ZwinnySerwis/axidraw-modern/tools/ebb_sim/README.md

# Emulator protokołu EBB

Model firmware bez płytki. Testy:

```powershell
python -m pytest
```

Interakcja z terminala (jedna komenda na linię):

```powershell
python -m tools.ebb_sim.repl
```
