ZwinnySerwis/axidraw-modern/hardware/PROTO-SCIEGA.html

# axidraw-modern — ściąga prototypu (Pico RP2040)

UF2: firmware/build/axidraw_modern.uf2 · BOOTSEL → dysk RPI-RP2 · LED miga = żyje · USB ma się nazywać EiBotBoard

## Pico — USB u góry, numery nóżek płytki

 lewa (1–20)              prawa (40–21)
 GP0  1  ●          ● 40 VBUS     USB
 GP1  2  ●          ● 39 VSYS
 GND  3  ●          ● 38 GND
 GP2  4  ● STEP1    ● 37 3V3_EN
 GP3  5  ● DIR1     ● 36 3V3(OUT)  → logika sticków
 GP4  6  ● EN1      ● 35 ADC_VREF
 GP5  7  ● STEP2    ● 34 GP28 ADC VMOT
 GND  8  ●          ● 33 GND
 GP6  9  ● DIR2     ● 32 GP27 I2C1 SCL  [później]
 GP7 10  ● EN2      ● 31 GP26 I2C1 SDA  [później]
 GP8 11  ● TMC TX   ● 30 RUN
 GP9 12  ● TMC RX   ● 29 GP22 IMU INT1  [później]
 GND 13  ●          ● 28 GND
GP10 14  ● MS1      ● 27 GP21 spare
GP11 15  ● MS2      ● 26 GP20 spare
GP12 16  ● MS3      ● 25 GP19 SPI MOSI  [później]
GP13 17  ● EN3      ● 24 GP18 SPI SCK   [później]
 GND 18  ●          ● 23 GND
GP14 19  ● PAUSE    ● 22 GP17 SPI CS    [później]
GP15 20  ● SERVO    ● 21 GP16 SPI MISO  [później]

GP = numer w firmware. Nóżka = dziurka na Pico. LED = GP25 onboard, nie łączyć.

## Teraz na stole (żółte)

Sygnał | GP | Nóżka | Dokąd
STEP1 | 2 | 4 | stick 1 STEP
DIR1 | 3 | 5 | stick 1 DIR
EN1 (LOW=on) | 4 | 6 | stick 1 EN
STEP2 (+ stick 3) | 5 | 7 | stick 2 i 3 STEP
DIR2 (+ stick 3) | 6 | 9 | stick 2 i 3 DIR
EN2 (LOW=on) | 7 | 10 | stick 2 EN
MS1 / MS2 / MS3 | 10/11/12 | 14/15/16 | luz = pełny krok; firmware MOTION_STEP_DIV=16. 1/16: MS→3V3 i DIV=1
EN3 (LOW=on) | 13 | 17 | stick 3 EN
PAUSE | 14 | 19 | przycisk → GND (pull-up w Pico)
SERVO PWM | 15 | 20 | sygnał serwa (nie 5 V z Pico)
ADC VMOT | 28 | 34 | dzielnik 12 V → 3V3 max
3V3 | — | 36 | VDD sticków, SLEEP, RESET
GND | — | 3/8/13/18/23/28/33/38 | wspólna masa ze zasilaczem silników

## Stepstick 16-pin (A4988 / DRV8825 / TMC) — EN u góry z lewej

 EN     ● ●  VMOT     ← 12–24 V z zasilacza, NIE z Pico
 MS1    ● ●  GND      ← masa wspólna
 MS2    ● ●  2B (B−)  ← silnik
 MS3    ● ●  2A (B+)
 RESET  ● ●  1A (A+)  ← RESET i SLEEP do 3V3
 SLEEP  ● ●  1B (A−)
 STEP   ● ●  VDD      ← 3V3 z Pico
 DIR    ● ●  GND

TMC: UART-off (zwory jak A4988). Stick 3: STEP+DIR z sticka 2, EN osobno. Nie łącz cewek dwóch silników na jeden stick.

## Zasilanie — trzy szyny

Szyna | Co
VMOT 12–24 V | tylko VMOT na stickach. Pico tego nie pije.
5 V (buck) | serwo. Nie VBUS Pico pod obciążeniem.
3V3 z Pico | VDD / SLEEP / RESET / MS logika

- USB = debug Pico bez silników.
- Plot: VMOT z zasilacza, GND zasilacza ↔ GND Pico.
- EN aktywne 0. STEP = narastające zbocze.
- Zła strona ramy → odwróć DIR w firmware, nie w pluginie.

## Później (nie na pierwszy proto)

Co | GP | Nóżka
AS5600 #1 I2C0 SDA/SCL | 0 / 1 | 1 / 2
AS5600 #2 I2C1 SDA/SCL | 26 / 27 | 31 / 32
LSM6 SPI MISO/CS/SCK/MOSI | 16–19 | 21–24
LSM6 INT1 | 22 | 29
TMC UART TX/RX | 8 / 9 | 11 / 12
spare | 20 / 21 | 26 / 27

AS5600 adres 0x36 na stałe (zmiana adresu = chip AS5600L). Dwa I2C zostają.

## Kolejność składania

1. Tylko Pico + USB → UF2 → LED miga, Windows: EiBotBoard.
2. GND wspólna, 3V3 na VDD sticków, SLEEP+RESET=3V3. Bez VMOT.
3. STEP/DIR/EN/MS. Potem VMOT. Na końcu silniki.
4. Serwo: sygnał GP15, 5 V z bucka, GND wspólna.

Źródło: hardware/PINOUT.md · hardware/POWER.md · firmware/include/board_pins.h · 2026-10-10
