ZwinnySerwis/axidraw-modern/docs/upstream/oem/EBB_v27/EBB_v27/EiBotBoard_v27_BOM.xlsx

Sheet: Sheet1
EggBotBoard V2.7 BOM |  | These are changes since last (v2.6) BOM
 |  | Found in quantity at Digikey as of 1/20/2021
 |  | Part only available from Seeed
 |  | Not available anywhere as of 1/202/2021
Qty | Ref | Value | Mfg Part Number | Digi-Key part number | ERP代码 | Alt Mfg Part Number | Alt DigiKey Part Number | Note | Distributor (main part)
2 | IC1, IC2 | IC MOTOR DRIVER MICROSTEP 28-QFN | A4988SETTR-T | 620-1343-1-ND | 142009001 |  |  |  | Newark
1 | C14 | CAP ALUM 100UF 35V 20% SMD | UWT1V101MCL1GS | 493-2203-1-ND |  |  |  |  | Digi-Key
1 | IC4 | IC REG POS 0.5A ADJ VOLT DPAK | LM317MDTX | LM317MDTXFSCT-ND | 131054001 | LM317MADTRKG | LM317MADTRKGOSCT-ND |  | Digi-Key
1 | U1 | IC REG POS 0.5A 5V TO-252 | CJ78M05 |  | 1300040P1 | MC78M05CDTRKG | MC78M05CDTRKGOSCT-ND |  | Seeed
1 | IC3 | USB PIC Microcontroller | PIC18F46J50-I/PT | MicrochipDirect | 104017001 |  |  |  | Microchip Direct
1 | R11 | TRIMMER 10K OHM 0.1W J LEAD TOP | TC33X-2-103E | TC33X-103ECT-ND |  | TC33X-2-502E | TC33X-502ECT-ND | Footprint expanded to fit many 3mm trimmers now | Digi-Key
1 | D2 | DIODE SCHOTTKY SS0520-7-F | SS0520-7-F |  | 0390030P1 | B0520LW-7-F | B0520LW-FDICT-ND |  | Seeed
1 | D3 | RECTIFIER, SCHOTTKY, 0.5A, 40V | MBR0540 | 2156-MBR0540-ND | MBR0540 |  |  |  | Digi-Key
1 | D1 | DIODE SCHOTTKY 5A 40V SMB | SS54B-HF | 641-SS54B-HFCT-ND | 0310130P1 | SK54BTR | 1655-1604-1-ND |  | Digi-Key
4 | R1, R2, R3, R4 | RES .22 OHM 1/4W 1% 0805 SMD | MCR10EZHFLR220 |  | 002096001 | RL0805FR-7W0R22L | 311-0.22LUCT-ND |  | Seeed
2 | R7, R8 | RES 20K OHM 1/8W 5% 00603 SMD |  |  | 002066001 | RMCF0603FT20K0 | RMCF0603FT20K0CT-ND |  | Seeed
1 | F1 | PPTC-500mA 1206 | 0900030P1 |  | 0900030P1 | 0ZCJ0025AF2E | 507-1799-1-ND |  | Seeed
2 | J1, J2 | TERM BLOCK 4POS SIDE ENT 3.5MM | 1776275-4 | A98038-ND | 347032002 |  |  |  | Digi-Key
2 | SW1, SW2 | SWITCH TACT SMT SPST 160GF | PTS525SM10SMTR LFS | CKN9104CT-ND | 310016001 |  |  |  | Digi-Key
15 | C1, C2, C3, C4, C5, C6, C7, C8, C11, C12, C15, C18, C19, C20, C26 | CAP CERAMIC .100UF 50V X7R 0603 | C0603C104K5RACTU | 399-5089-1-ND | 0100020P1 |  |  |  | Digi-Key
3 | USR, LED1, LED2 | LED RED CLEAR 2SMD | 19-217/R6C-AL1M2VY/3T | 1080-1585-1-ND | 0330020P1 |  |  |  | Digi-Key
2 | USB, PWR | LED-SMD Green Clear 0603 | 19-217/G7C-AN1P2/3T |  | 0330010P1 | 19-213/GVC-AMNB/3T | 1080-1576-1-ND |  | Seeed
8 | R5, R6, R9, R10, R21, R22, R28, R29 | SMD RES 10K-5%-1/10W 0603 | RC0603JR-0710KL | 311-10KGRCT-ND | 0010170P1 |  |  |  | Digi-Key
2 | C13, C17 | SMD CAP Ceramic 10uF-25V-10%-X5R | CC0805KKX5R8BB106 | 311-1869-1-ND | 0100080P1 |  |  |  | Digi-Key
5 | R15, R16, R20, R25, R26 | SMD RES 330R-5%-1/10W | RC0603JR-07330RL | 311-330GRCT-ND | 0010430P1 |  |  |  | Digi-Key
2 | R12, R14 | SMD RES 4.7K-5%-1/10W | RC0603JR-074K7L | 311-4.7KGRCT-ND | 0010030P1 |  |  |  | Digi-Key
2 | R17, R13 | SMD RES 8.2K-5%-1/8W | RC0805JR-078K2L | 311-8.2KARCT-ND | 0020360P1 |  |  |  | Digi-Key
3 | C16, C21, C27 | CAP CERAMIC 1.00UF 25V X7R 0603 | CC0805KKX7R8BB105 | 311-1456-1-ND | 0100340P1 |  |  |  | Digi-Key
1 | R27 | RES SMD 390 OHM 5% 1/10W 0603 | RC0603JR-07390RL | 311-390GRCT-ND | 0010600P1 |  |  |  | Digi-Key
1 | R23 | RES 240 OHM 1/10W 5% 0603 SMD | ERJ-3GEYJ241V | P240GCT-ND | 001044001 |  |  |  | Digi-Key
1 | J7 | CONN POWER JACK 2.1MM | DC-005 |  | 3410020P1 | 54-00166 | 839-54-00166-ND |  | Seeed
1 | J3 | CONN USB MICRO B RECPT SMT R/A | 10118194-0001LF | 609-4618-1-ND |  |  |  |  | Digi-Key
2 | C9, C10 | CAP CER .22UF 50V Y5V 0603 | C1608Y5V1H224Z | 445-3455-1-ND | 010031001 | CC0603ZRY5V9BB224 | 311-1830-1-ND |  | Digi-Key
1 | R18 | SMD RES 1K-5%-1/10W | RC0603JR-071KL | 311-1.0KGRCT-ND | 0010060P1 |  |  |  | Digi-Key
4 | JP1, JP2, JP3, JP4 | BERGSTIK II .100" SR STRAIGHT |  |  | 3460810P1 |  |  | (any standard 0.1" headers) | Any
1 | U5 | MOSFET N/P-CH 25V/12V TSOT26 | DMC25D1UVT-7 | DMC25D1UVT-7DICT-ND |  | DMC25D0UVT-7 | DMC25D0UVT-7DICT-ND |  | Digi-Key
0 | J4, J5, JP5, JP6, JP7, JP8, ICSP, TP1, TP2, TP3, J6, D4 | Do not insert parts

Sheet: Sheet2
Pin | Number | Use | Left | 33 | Need: | 20 for motor drivers | SLEEP
RH2 | 1 | JP2 IO | LATCH |  |  | 6 for MISC | MS1
RH3 | 2 | JP2 IO | DIG_1 |  | Leavs: | 7 spare | MS2
RE1 | 3 | MS2_1 | DIG_2 |  |  |  | PFD
RE0 | 4 | MS1_1 | PRG | RC2 |  |  | ENABLE
RG0 | 5 | DIG_1 | USR_LED | RC1
RG1 | 6 | TX2 | USB_LED | RC0
RG2 | 7 | RX2
RG3 | 8 | DIG_2
MCLR | 9 | MCLR
RG4 | 10 | SPARE1
VSS | 11 | PWR
VDDCORE/VCAP | 12 | PWR
RF7 | 13 | PFD_4
RF6 | 14 | PFD_3
RF5 | 15 | PFD_2
RF4 | 16 | D+
RF3 | 17 | D-
RF2 | 18 | PFD_1
RH7 | 19 | JP2 IO
RH6 | 20 | JP2 IO
RH5 | 21 | JP2 IO
RH4 | 22 | JP2 IO
VUSB | 23 | PWR
ENVREG | 24 | PWR
AVDD | 25 | PWR
AVSS | 26 | PWR
RA3 | 27 | SPARE2
RA2 | 28 | SPARE3
RA1 | 29 | SPARE4
RA0 | 30 | SPARE5
VSS | 31 | PWR
VDDCORE/VCAP | 32 | PWR
RA5 | 33 | SPARE6
RA4 | 34 | LATCH
RC1 | 35 | JP1 IO
RC0 | 36 | JP1 IO
RC6 | 37 | JP1 IO
RC7 | 38 | JP1 IO
RJ4 | 39 | ENABLE_1
RJ5 | 40 | ENABLE_2
RJ6 | 41 | ENABLE_3
RJ7 | 42 | ENABLE_4
RC2 | 43 | JP1 IO
RC3 | 44 | JP1 IO
RC4 | 45 | JP1 IO
RC5 | 46 | JP1 IO
RB7 | 47 | DIR_4
VDD | 48 | PWR
OSC1 | 49 | -
OSC2 | 50 | -
VSS | 51 | PWR
RB6 | 52 | STEP_4
RB5 | 53 | DIR_3
RB4 | 54 | STEP_3
RB3 | 55 | DIR_2
RB2 | 56 | STEP_2
RB1 | 57 | DIR_1
RB0 | 58 | STEP_1
RJ3 | 59 | SLEEP_4
RJ2 | 60 | SLEEP_3
RJ1 | 61 | SLEEP_2
RJ0 | 62 | SLEEP_1
RD7 | 63 | SS
RD6 | 64 | SCK
RD5 | 65 | SDI_IN
RD4 | 66 | SDO_OUT
RD3 | 67 | SPARE7
RD2 | 68 | PRG
RD1 | 69 | USR_LED
VSS | 70 | PWR
VDD | 71 | PWR
RD0 | 72 | USB_LED
RE7 | 73 | MS2_4
RE6 | 74 | MS1_4
RE5 | 75 | MS2_3
RE4 | 76 | MS1_3
RE3 | 77 | MS2_2
RE2 | 78 | MS1_2
RH0 | 79 | JP2 IO
RH1 | 80 | JP2 IO
