ZwinnySerwis/axidraw-modern/docs/upstream/EiBotBoard-v26_sch.pdf

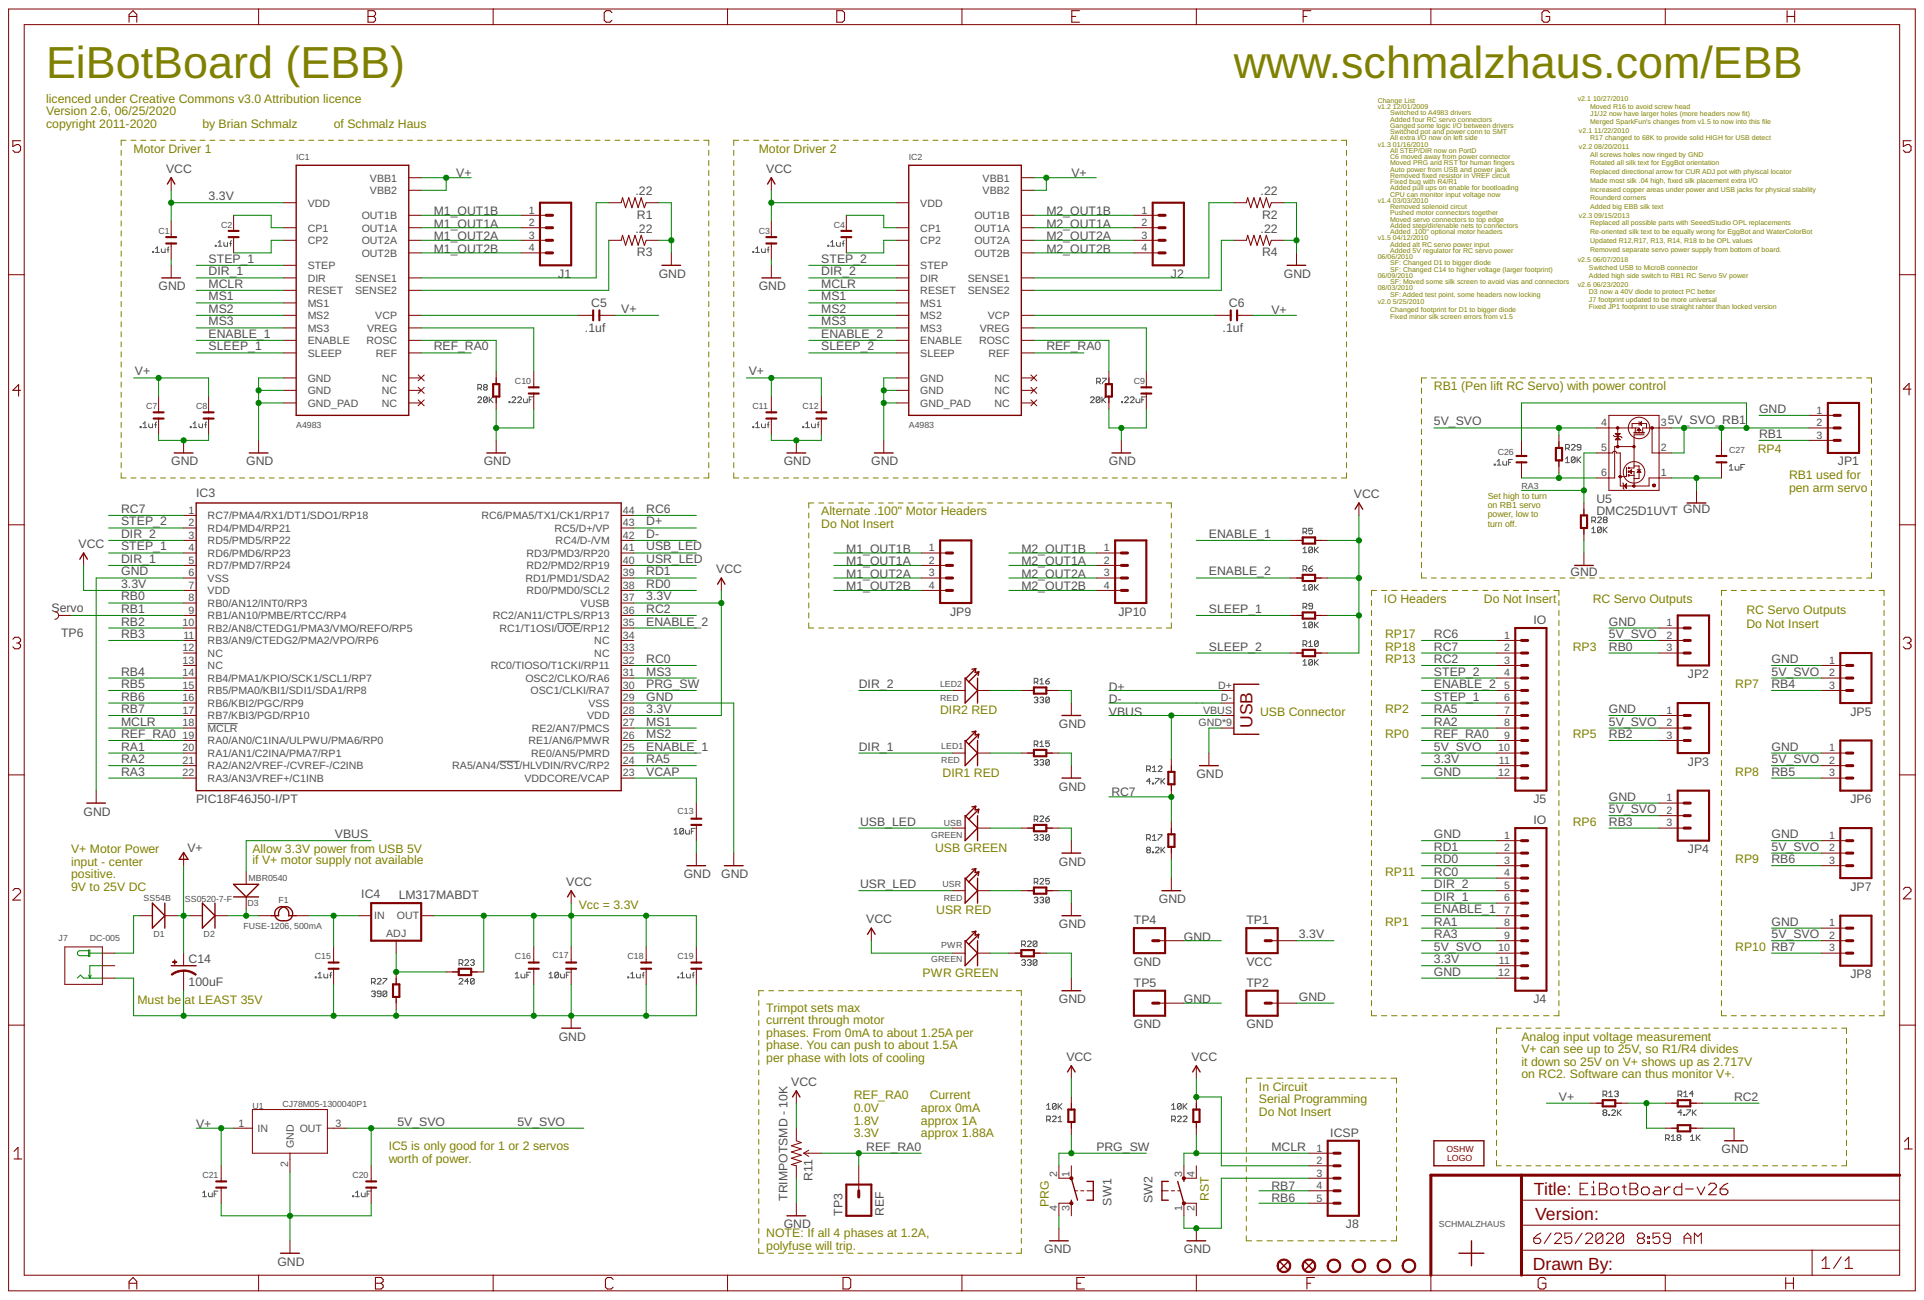
[picture p1: page 1]

licenced under Creative Commons v3.0 Attribution licence
Version 2.6, 06/25/2020
copyright 2011-2020

Change List Switched to A4983 drivers Added four RC servo connectors Ganged some logic I/O between drivers Switched pot and power conn to SMT All extra I/O now on left side

v2.1 10/27/2010 Moved R16 to avoid screw head

v2.1 11/22/2010 R17 changed to 68K to provide solid HIGH for USB detect v2.2 08/20/2011 All screws holes now ringed by GND

J1/J2 now have larger holes (more headers now fit) Merged SparkFun's changes from v1.5 to now into this file

v1.3 01/16/2010 All STEP/DIR now on PortD

C6 moved away from power connector Moved PRG and RST for human fingers Auto power from USB and power jack Removed fixed resistor in VREF circuit Fixed bug with R4/R1 CPU can monitor input voltage now

Rotated all silk text for EggBot orientation Replaced directional arrow for CUR ADJ pot with phyiscal locator Made most silk .04 high, fixed silk placement extra I/O

Added pull ups on enable for bootloading

Increased copper areas under power and USB jacks for physical stability Rounderd corners Added big EBB silk text

v1.4 03/03/2010 Removed solenoid circut Pushed motor connectors together Moved servo connectors to top edge Added step/dir/enable nets to connectors Added .100" optional motor headers

v2.3 09/15/2013 Replaced all possible parts with SeeedStudio OPL replacements Re-oriented silk text to be equally wrong for EggBot and WaterColorBot

v1.5 04/12/2010 Added alt RC servo power input Added 5V regulator for RC servo power

Updated R12,R17, R13, R14, R18 to be OPL values Removed separate servo power supply from bottom of board.

06/06/2010 SF: Changed D1 to bigger diode SF: Changed C14 to higher voltage (larger footprint) 06/09/2010 SF: Moved some silk screen to avoid vias and connectors 08/03/2010 SF: Added test point, some headers now locking

v2.5 06/07/2018 Switched USB to MicroB connector Added high side switch to RB1 RC Servo 5V power

v2.6 06/23/2020 D3 now a 40V diode to protect PC better J7 footprint updated to be more universal Fixed JP1 footprint to use straight rahter than locked version

v2.0 5/25/2010 Changed footprint for D1 to bigger diode Fixed minor silk screen errors from v1.5

RB1 (Pen lift RC Servo) with power control

RB1 used for pen arm servo

Set high to turn
on RB1 servo
power, low to
turn off.

Do Not Insert Alternate .100" Motor Headers

RC Servo Outputs Do Not Insert

if V+ motor supply not available V+ Motor Power
input - center positive. 9V to 25V DC

Allow 3.3V power from USB 5V

Trimpot sets max
current through motor phases. From 0mA to about 1.25A per

GND

Analog input voltage measurement on RC2. Software can thus monitor V+.
V+ can see up to 25V, so R1/R4 divides
it down so 25V on V+ shows up as 2.717V

phase. You can push to about 1.5A

In Circuit Serial Programming Do Not Insert

IC5 is only good for 1 or 2 servos worth of power.

Drawn By: Title: Version:

NOTE: If all 4 phases at 1.2A, polyfuse will trip.

SCHMALZHAUS
