ZwinnySerwis/axidraw-modern/docs/upstream/oem/EBB_v27/EBB_v27/EiBotBoard-v27_assembly.pdf

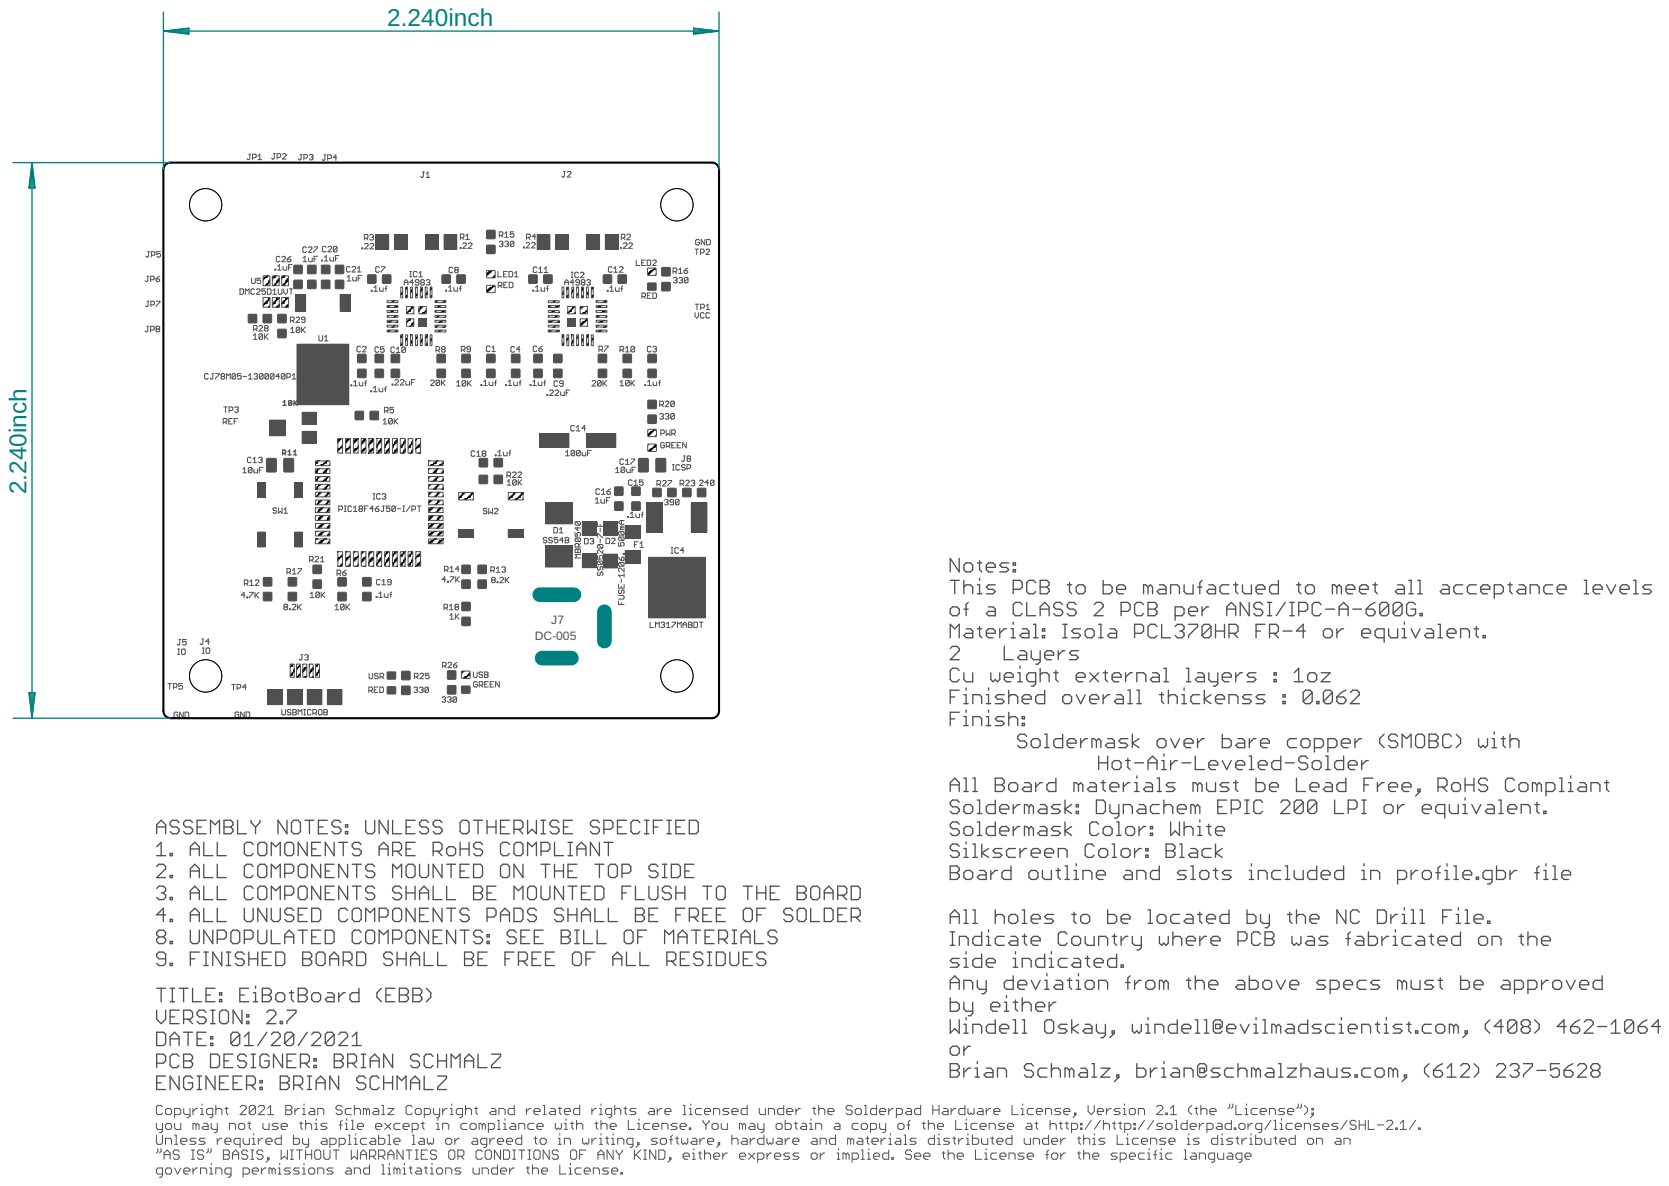
[picture p2: page 1]
