ZwinnySerwis/axidraw-modern/docs/upstream/EiBotBoard-v26_brd.pdf

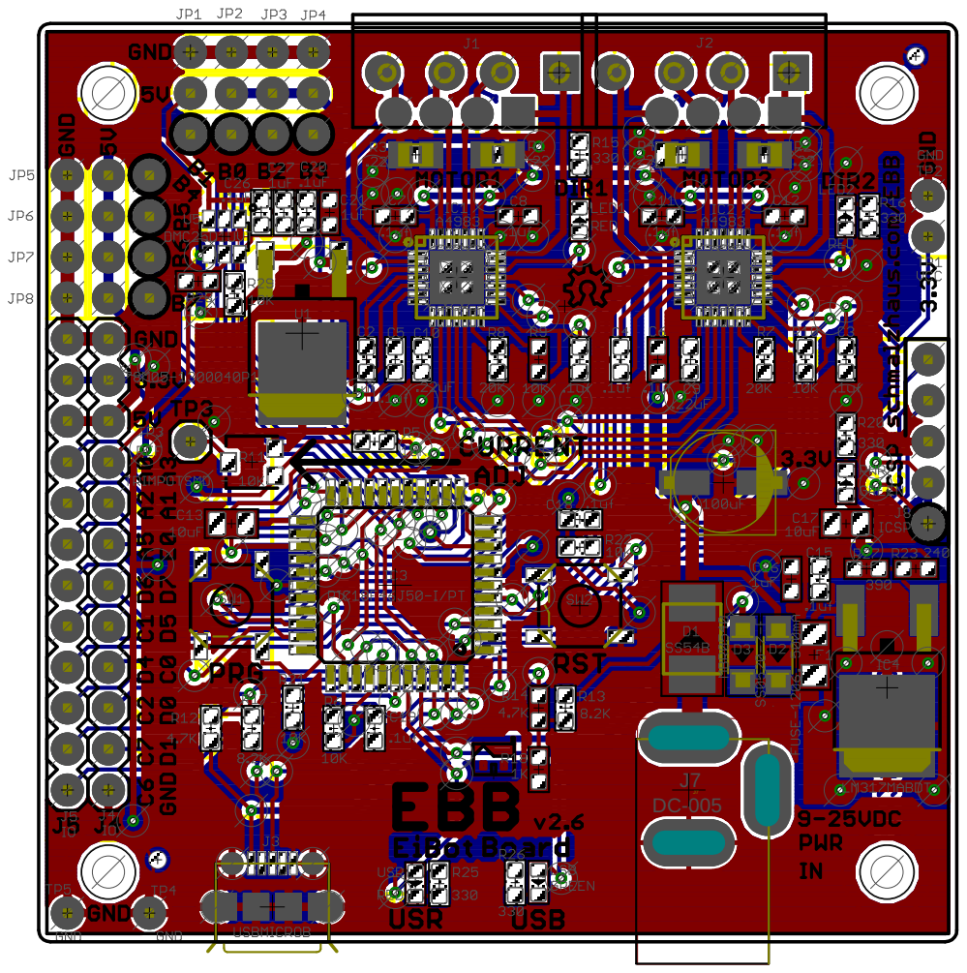
[picture p3: page 1]
