ZwinnySerwis/axidraw-modern/docs/upstream/oem/EBB_v27/EBB_v27/EiBotBoard-v27_brd.pdf

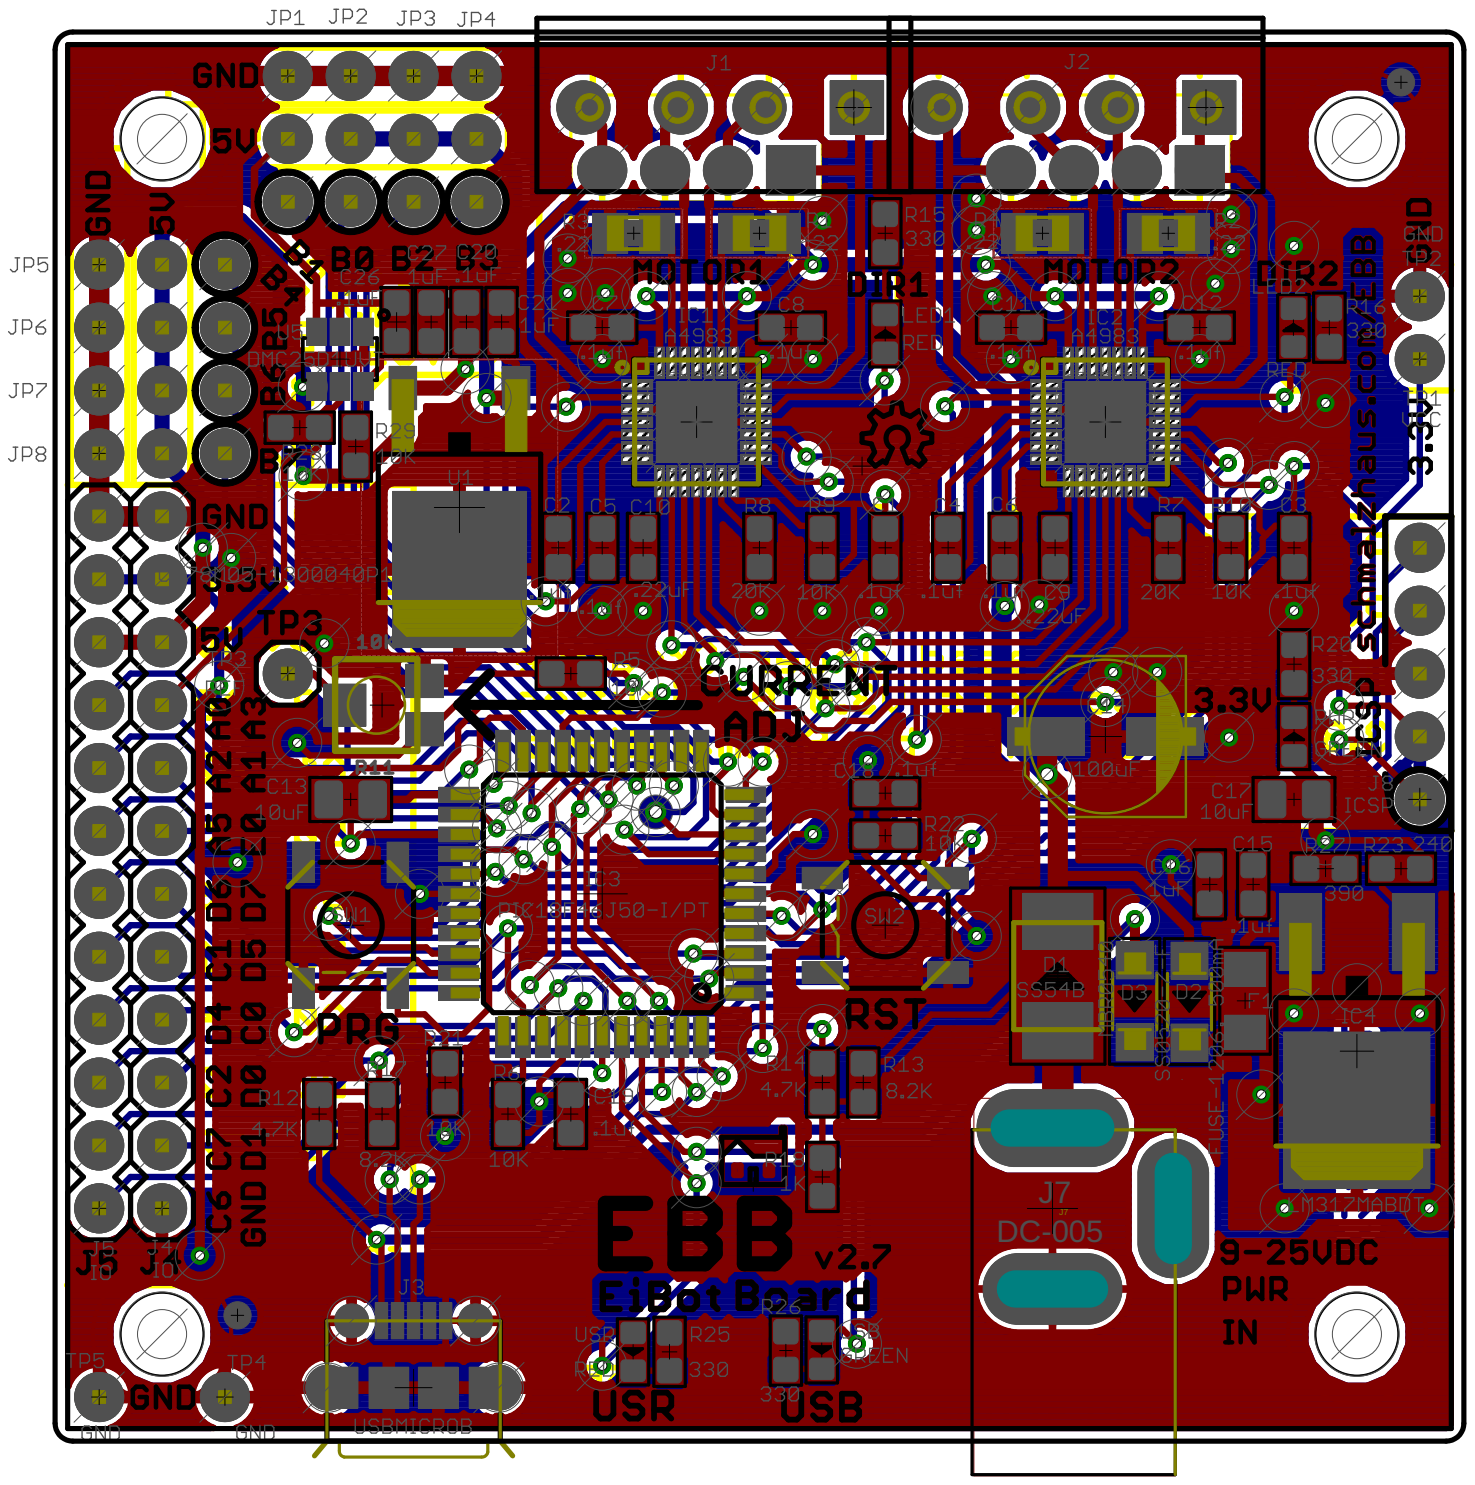
[picture p4: page 1]
