ZwinnySerwis/axidraw-modern/docs/upstream/oem/EBB_v27/EBB_v27/EiBotBoard-v27.brd

## EAGLE design docs/upstream/oem/EBB_v27/EBB_v27/EiBotBoard-v27.brd (2026-10-10)

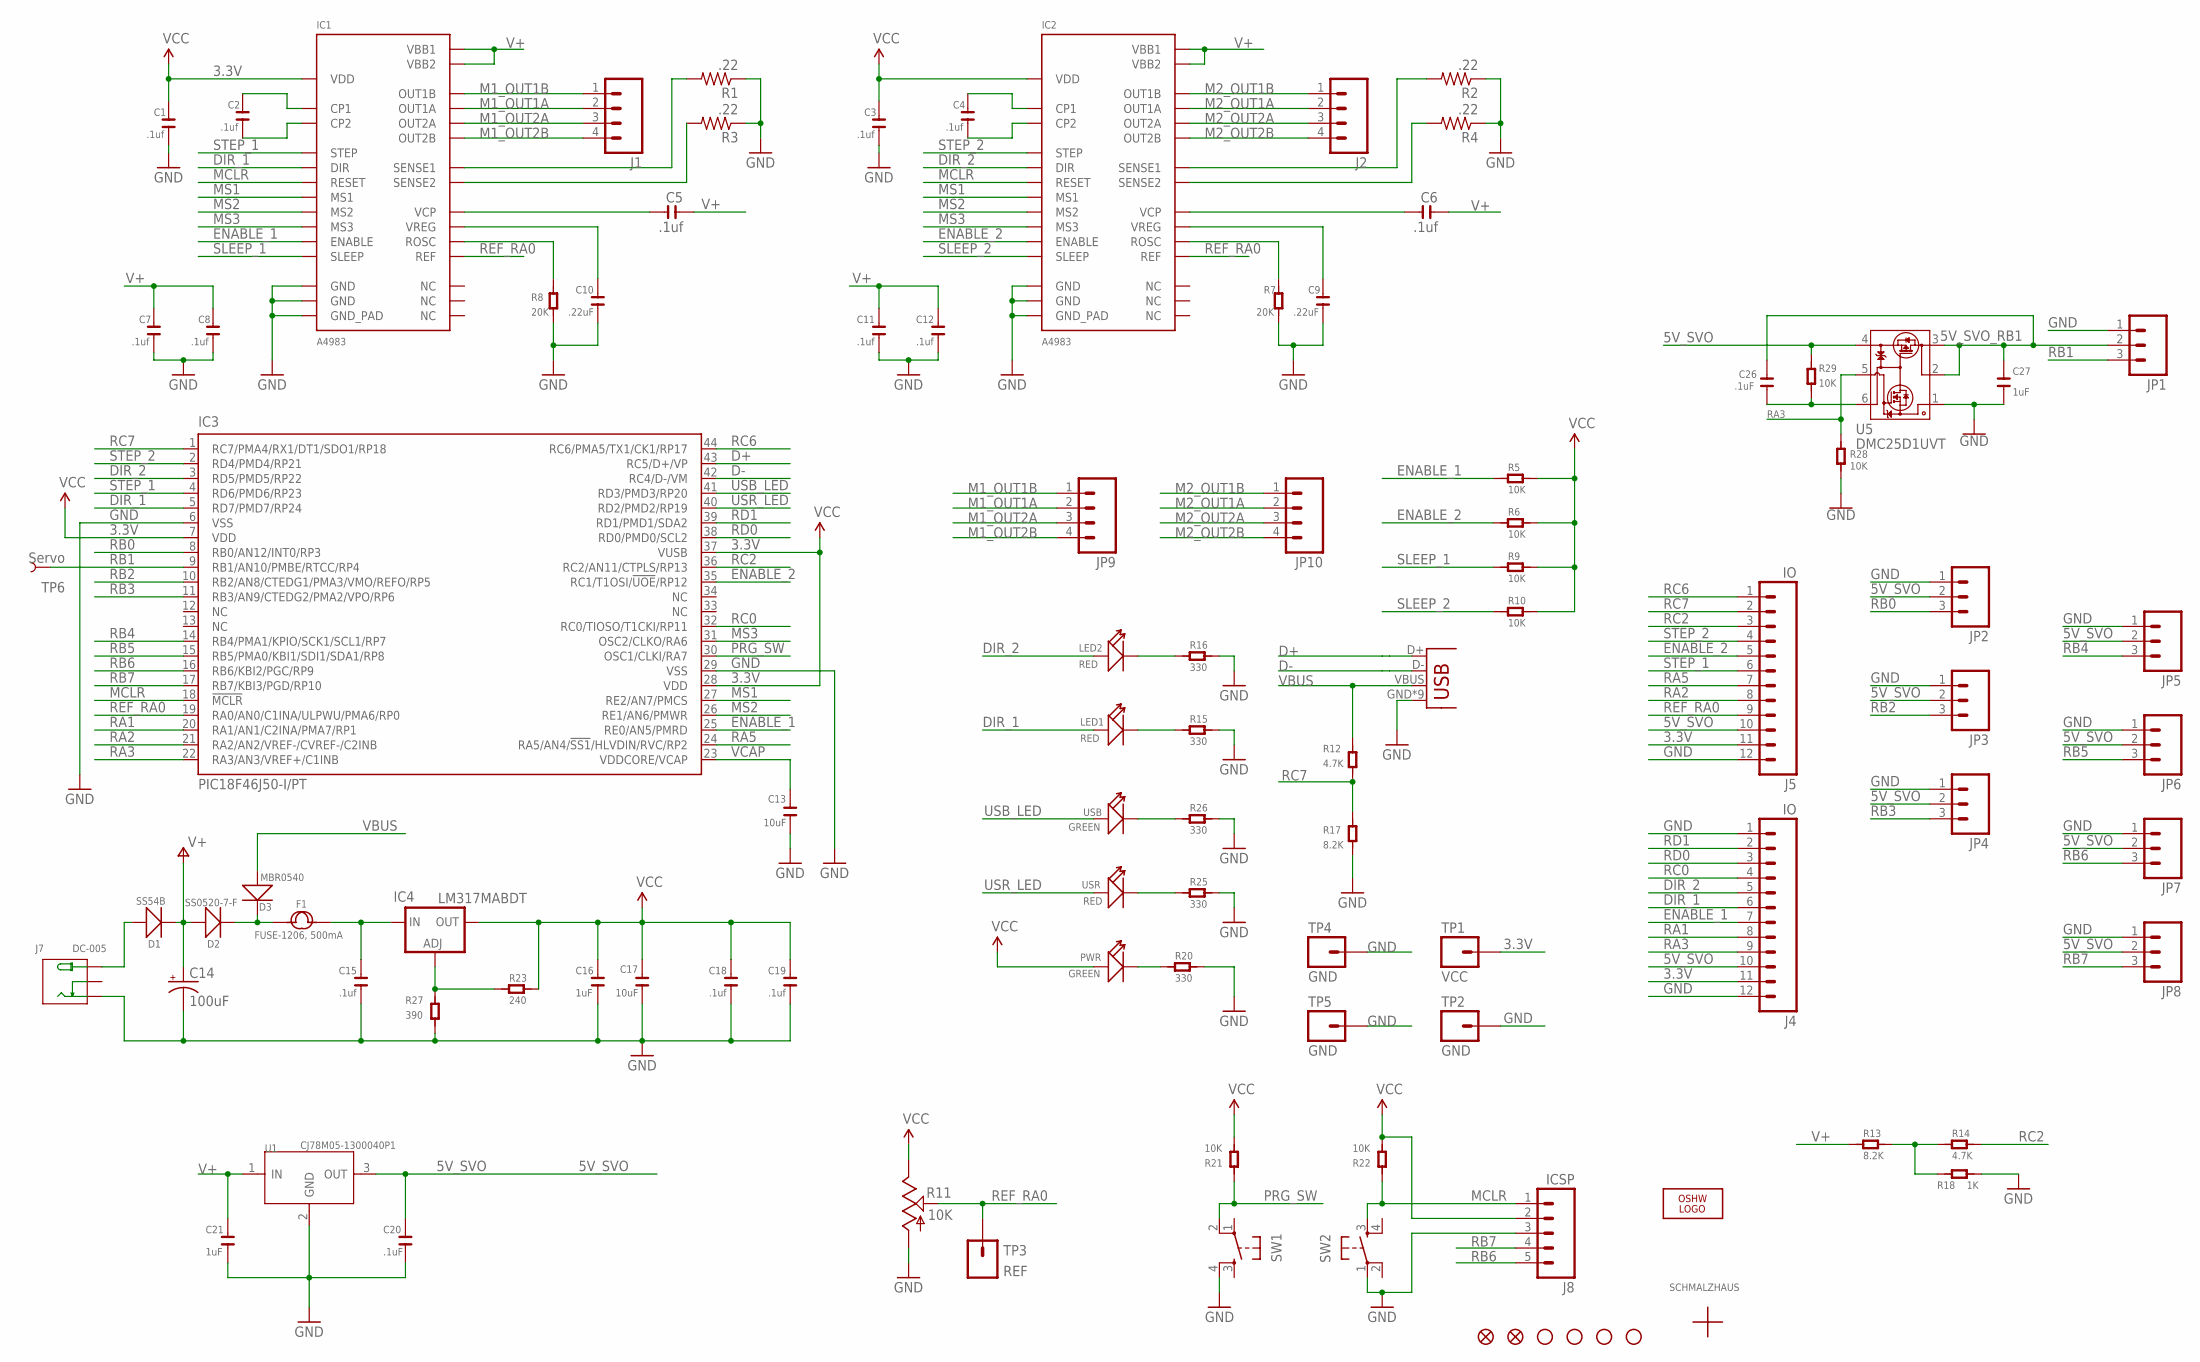
[picture p5: schematic EiBotBoard-v27.sch]

Parts:
C1, C2, C3, C4, C5, C6, C7, C8, C11, C12, C15, C18, C19: .1uf; C0603
C9, C10: .22uF; C0603
C13, C17: 10uF; C0805
C14: 100uF; PANASONIC_D
C16, C21, C27: 1uF; C0603
C20, C26: .1uF; C0603
D1: SS54B; SMB
D2: SS0520-7-F; SOD123
D3: MBR0540; SOD123
F1: FUSE-1206, 500mA; F1206
IC1, IC2: A4983; QFN28
IC3: PIC18F46J50-I/PT; TQFP44
IC4: LM317MABDT; DPACK
J1, J2: SCHMALZHAUS_M04; SCHMALZHAUS_SCREWTERMINAL-3.5MM-4_LOCK
J3: USBMICROB; USB-MICROB_FCI_PINS
J4, J5: IO; 1X12
J7: DC-005; DCJ3P-14.2X11.0X9.0MM
J8: ICSP; 1X05_NOSILK
JP1, JP2, JP3, JP4, JP5, JP6, JP7, JP8: M031X03_NO_SILK; 1X03_NO_SILK
JP9, JP10: M04POLAR; MOLEX-1X4
JP14, JP15: FIDUCIAL1X2; FIDUCIAL-1X2
LED1, LED2: RED; LED0603
LOGO1: OSHW_LOGO_8MILX0100-NT; OSHW_8X100_NOTEXT
PWR: GREEN; LED0603
R1, R2, R3, R4: .22; R0805
R5, R6, R9, R10, R21, R22, R28, R29: 10K; R0603
R7, R8: 20K; R0603
R11: 10K; 3MM_GENERIC_TRIMMER_POT
R12, R14: 4.7K; R0603
R13, R17: 8.2K; R0603
R15, R16, R20, R25, R26: 330; R0603
R18: 1K; R0603
R23: 240; R0603
R27: 390; R0603
SW1: PRG; TACTILE_SWITCH_SMD
SW2: RST; TACTILE_SWITCH_SMD
TP1: VCC; 1X01_NOSILK
TP2, TP4, TP5: GND; 1X01_NOSILK
TP3: REF; 1X01
TP6: Servo; PAD.03X.05
U1: CJ78M05-1300040P1; TO252
U5: DMC25D1UVT; TSOT26
U$1: SCHMALZHAUSSCHMALZHAUS_SMALL; SCHMALZHAUS_SMALL
U$2, U$3, U$4, U$5: STAND-OFF
USB: GREEN; LED0603
USR: RED; LED0603

Connections:
3.3V: C1.1, C3.1, C16.2, C17.2, C18.2, C19.2, IC1.P$15 (VDD), IC2.P$15 (VDD), IC3.7 (VDD), IC3.28 (VDD), IC3.37 (VUSB), IC4.4 (OUT), J4.11, J5.11, J8.2, PWR.+, R5.1, R6.1, R9.1, R10.1, R11.1 (E), R21.2, R22.2, R23.2, TP1.1
5V_SVO: C20.2, J4.10, J5.10, JP2.2, JP3.2, JP4.2, JP5.2, JP6.2, JP7.2, JP8.2, R29.1, U1.3 (OUT), U5.4 (VIN_R1)
5V_SVO_RB1: C26.1, C27.1, JP1.2, U5.2 (VOUT_C1$2), U5.3 (VOUT_C1$1)
D+: IC3.43 (RC5/D+/VP), J3.D+
D-: IC3.42 (RC4/D-/VM), J3.D-
DIR_1: IC1.P$19 (DIR), IC3.5 (RD7/PMD7/RP24), J4.6, LED1.+
DIR_2: IC2.P$19 (DIR), IC3.3 (RD5/PMD5/RP22), J4.5, LED2.+
ENABLE_1: IC1.P$2 (ENABLE), IC3.25 (RE0/AN5/PMRD), J4.7, R5.2
ENABLE_2: IC2.P$2 (ENABLE), IC3.35 (RC1/T1OSI/!UOE!/RP12), J5.5, R6.2
GND: C1.2, C3.2, C7.2, C8.2, C9.2, C10.2, C11.2, C12.2, C13.1, C14.-, C15.1, C16.1, C17.1, C18.1, C19.1, C20.1, C21.1, C27.2, IC1.P$3 (GND), IC1.P$18 (GND), IC1.P$29 (GND_PAD), IC2.P$3 (GND), IC2.P$18 (GND), IC2.P$29 (GND_PAD), IC3.6 (VSS), IC3.29 (VSS), J3.GND, J3.GND@1 (GND), J3.GND@2 (GND), J3.GND@3 (GND), J3.GND@4 (GND), J3.GND@5 (GND), J3.GND@6 (GND), J3.GND@7 (GND), J3.GND@8 (GND), J4.1, J4.12, J5.12, J7.P$2 (-), J8.3, JP1.1, JP2.1, JP3.1, JP4.1, JP5.1, JP6.1, JP7.1, JP8.1, R1.1, R2.1, R3.1, R4.1, R7.2, R8.2, R11.3 (A), R15.1, R16.1, R17.2, R18.2, R20.1, R25.1, R26.1, R27.2, R28.2, SW1.4, SW2.1, TP2.1, TP4.1, TP5.1, U1.2 (GND), U5.1 (R2)
M1_OUT1A: IC1.P$24 (OUT1A), J1.2, JP9.2
M1_OUT1B: IC1.P$21 (OUT1B), J1.1, JP9.1
M1_OUT2A: IC1.P$26 (OUT2A), J1.3, JP9.3
M1_OUT2B: IC1.P$1 (OUT2B), J1.4, JP9.4
M2_OUT1A: IC2.P$24 (OUT1A), J2.2, JP10.2
M2_OUT1B: IC2.P$21 (OUT1B), J2.1, JP10.1
M2_OUT2A: IC2.P$26 (OUT2A), J2.3, JP10.3
M2_OUT2B: IC2.P$1 (OUT2B), J2.4, JP10.4
MCLR: IC1.P$12 (RESET), IC2.P$12 (RESET), IC3.18 (!MCLR!), J8.1, R22.1, SW2.3
MS1: IC1.P$9 (MS1), IC2.P$9 (MS1), IC3.27 (RE2/AN7/PMCS)
MS2: IC1.P$10 (MS2), IC2.P$10 (MS2), IC3.26 (RE1/AN6/PMWR)
MS3: IC1.P$11 (MS3), IC2.P$11 (MS3), IC3.31 (OSC2/CLKO/RA6)
unnamed: LED2.-, R16.2
unnamed: D2.-, D3.-, F1.1
unnamed: C2.1, IC1.P$4 (CP1)
unnamed: R13.2, R14.1, R18.1
unnamed: C2.2, IC1.P$5 (CP2)
unnamed: D1.+, J7.P$1 (+)
unnamed: LED1.-, R15.2
unnamed: R26.2, USB.-
unnamed: IC4.1 (ADJ), R23.1, R27.1
unnamed: R25.2, USR.-
unnamed: PWR.-, R20.2
unnamed: C4.1, IC2.P$4 (CP1)
unnamed: C4.2, IC2.P$5 (CP2)
unnamed: IC1.P$13 (ROSC), R8.1
unnamed: C10.1, IC1.P$8 (VREG)
unnamed: C5.1, IC1.P$6 (VCP)
unnamed: IC1.P$27 (SENSE2), R3.2
unnamed: IC1.P$23 (SENSE1), R1.2
unnamed: C15.2, F1.2, IC4.3 (IN)
unnamed: C6.1, IC2.P$6 (VCP)
unnamed: IC2.P$23 (SENSE1), R2.2
unnamed: IC2.P$27 (SENSE2), R4.2
unnamed: C9.1, IC2.P$8 (VREG)
unnamed: IC2.P$13 (ROSC), R7.1
unnamed: C26.2, R29.2, U5.6 (R1_C1)
PRG_SW: IC3.30 (OSC1/CLKI/RA7), R21.1, SW1.2
RA1: IC3.20 (RA1/AN1/C2INA/PMA7/RP1), J4.8
RA2: IC3.21 (RA2/AN2/VREF-/CVREF-/C2INB), J5.8
RA3: IC3.22 (RA3/AN3/VREF+/C1INB), J4.9, R28.1, U5.5 (ON/OFF)
RA5: IC3.24 (RA5/AN4/!SS1!/HLVDIN/RVC/RP2), J5.7
RB0: IC3.8 (RB0/AN12/INT0/RP3), JP2.3
RB1: IC3.9 (RB1/AN10/PMBE/RTCC/RP4), JP1.3, TP6.P$1
RB2: IC3.10 (RB2/AN8/CTEDG1/PMA3/VMO/REFO/RP5), JP3.3
RB3: IC3.11 (RB3/AN9/CTEDG2/PMA2/VPO/RP6), JP4.3
RB4: IC3.14 (RB4/PMA1/KPIO/SCK1/SCL1/RP7), JP5.3
RB5: IC3.15 (RB5/PMA0/KBI1/SDI1/SDA1/RP8), JP6.3
RB6: IC3.16 (RB6/KBI2/PGC/RP9), J8.5, JP7.3
RB7: IC3.17 (RB7/KBI3/PGD/RP10), J8.4, JP8.3
RC0: IC3.32 (RC0/TIOSO/T1CKI/RP11), J4.4
RC2: IC3.36 (RC2/AN11/CTPLS/RP13), J5.3, R14.2
RC6: IC3.44 (RC6/PMA5/TX1/CK1/RP17), J5.1
RC7: IC3.1 (RC7/PMA4/RX1/DT1/SDO1/RP18), J5.2, R12.2, R17.1
RD0: IC3.38 (RD0/PMD0/SCL2), J4.3
RD1: IC3.39 (RD1/PMD1/SDA2), J4.2
REF_RA0: IC1.P$17 (REF), IC2.P$17 (REF), IC3.19 (RA0/AN0/C1INA/ULPWU/PMA6/RP0), J5.9, R11.2 (S), TP3.1
SLEEP_1: IC1.P$14 (SLEEP), R9.2
SLEEP_2: IC2.P$14 (SLEEP), R10.2
STEP_1: IC1.P$16 (STEP), IC3.4 (RD6/PMD6/RP23), J5.6
STEP_2: IC2.P$16 (STEP), IC3.2 (RD4/PMD4/RP21), J5.4
USB_LED: IC3.41 (RD3/PMD3/RP20), USB.+
USR_LED: IC3.40 (RD2/PMD2/RP19), USR.+
V+: C5.2, C6.2, C7.1, C8.1, C11.1, C12.1, C14.+, C21.2, D1.-, D2.+, IC1.P$22 (VBB1), IC1.P$28 (VBB2), IC2.P$22 (VBB1), IC2.P$28 (VBB2), R13.1, U1.1 (IN)
VBUS: D3.+, J3.VBUS, R12.1
VCAP: C13.2, IC3.23 (VDDCORE/VCAP)

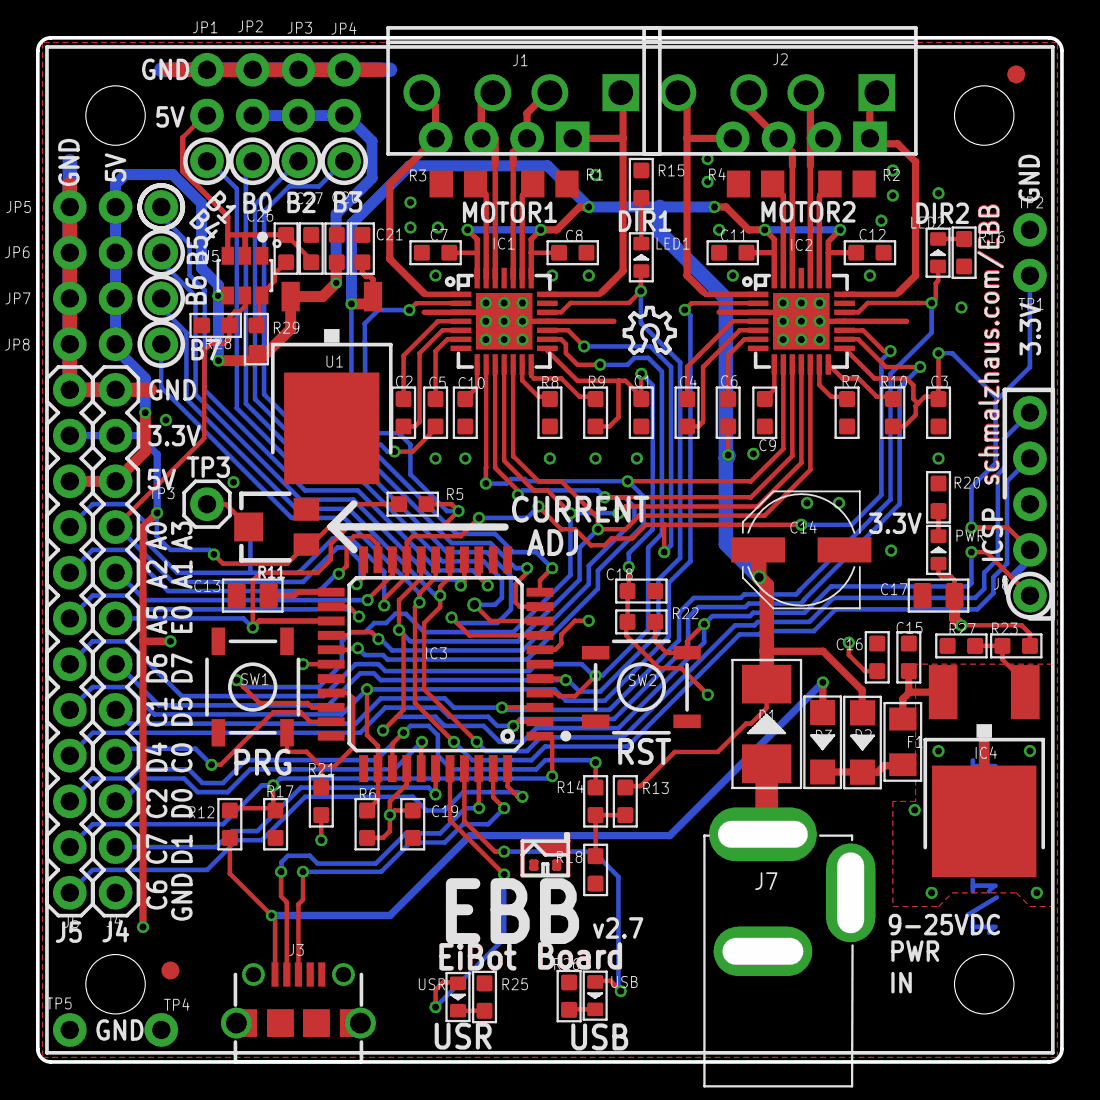
[picture p6: board EiBotBoard-v27.brd from above]

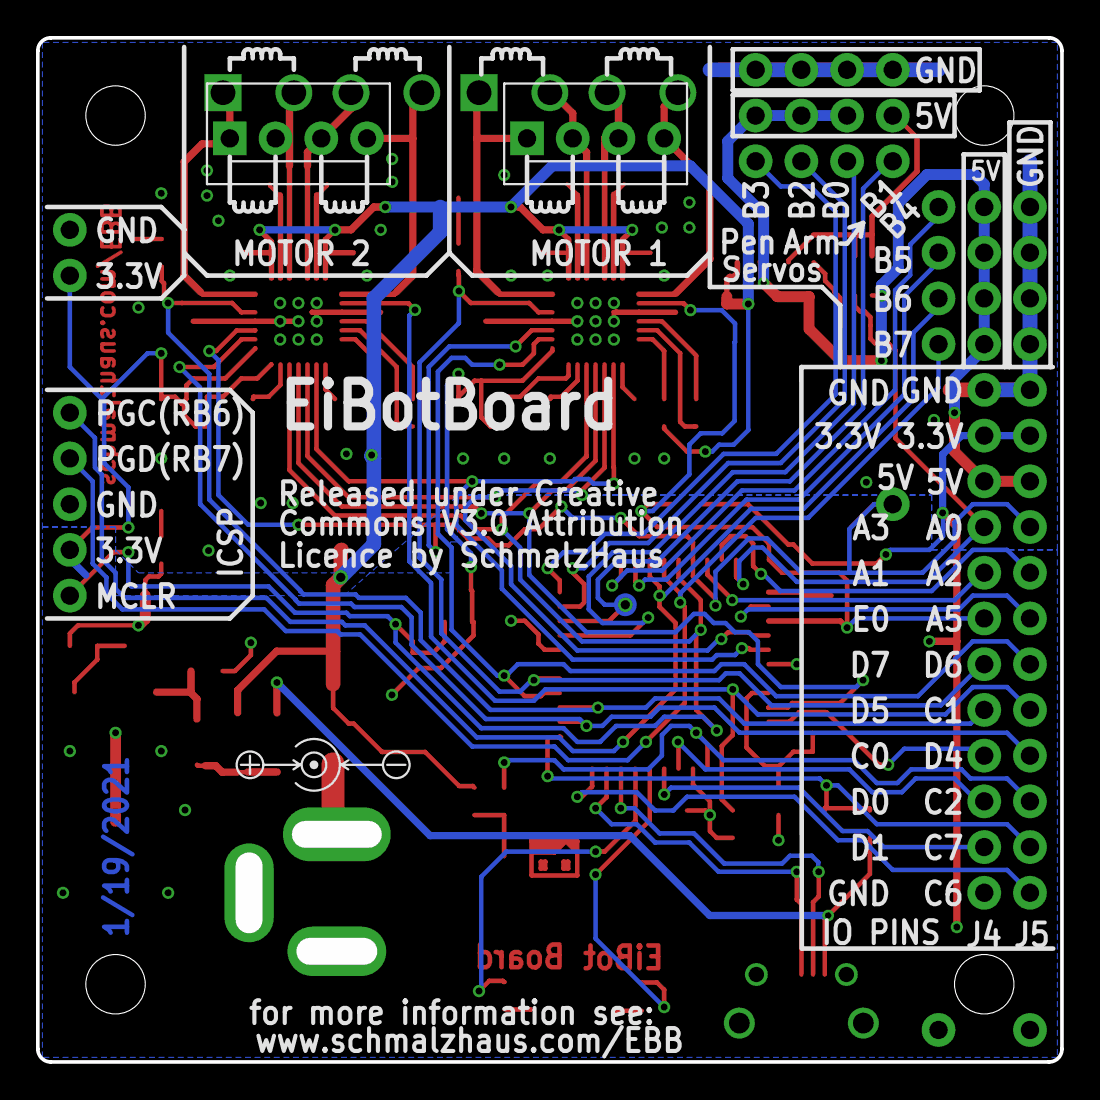
[picture p7: board EiBotBoard-v27.brd from below]

Board: 2 copper layers, 56.9 x 56.9 mm, 99 parts (3 on the bottom side), 76 nets.

Other parts of the board:
DRILEGEND: DRILEGEND
