ZwinnySerwis/axidraw-modern/(commit log)

2026-10-10 Bootstrap axidraw-modern: EBB-compatible firmware path with stepsticks.
    Keep the stock Inkscape plugin; vendor upstream sources and capture EBB schematics so the RP2040 board can speak the existing serial protocol.
2026-10-10 Lock MVP plan, OEM Eagle v2.7, and handoff for the Pico proto phase.
    [EiBotBoard-v27.brd, EiBotBoard-v27.sch, EiBotBoard_v27_BOM.xlsx, EiBotBoard_v27_BOM_EMSL.csv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]
2026-10-11 Lock Pico toolchain, EiBotBoard UF2 path, and proto pinout for three drivers.
