ZwinnySerwis/axidraw-modern/(notices)

Notices in the files:
docs/upstream/oem/EBB_v27/EBB_v27/EiBotBoard-v27.sch:
copyright 2011-2021
docs/upstream/oem/EBB_v27/EBB_v27/EiBotBoard-v27.brd:
Copyright 2021 Brian Schmalz Copyright and related rights are licensed under the Solderpad Hardware License, Version 2.1 (the "License");
Unless required by applicable law or agreed to in writing, software, hardware and materials distributed under this License is distributed on an
"AS IS" BASIS, WITHOUT WARRANTIES OR CONDITIONS OF ANY KIND, either express or implied. See the License for the specific language
parts and their libraries:
SparkFun-PowerSymbols: Licensing: Creative Commons ShareAlike 4.0 International - https://creativecommons.org/licenses/by-sa/4.0
